Exodus-Thanatos/LUMINARA/DesignProject/documentation/diagrams/Functional_Block_Diagram.png

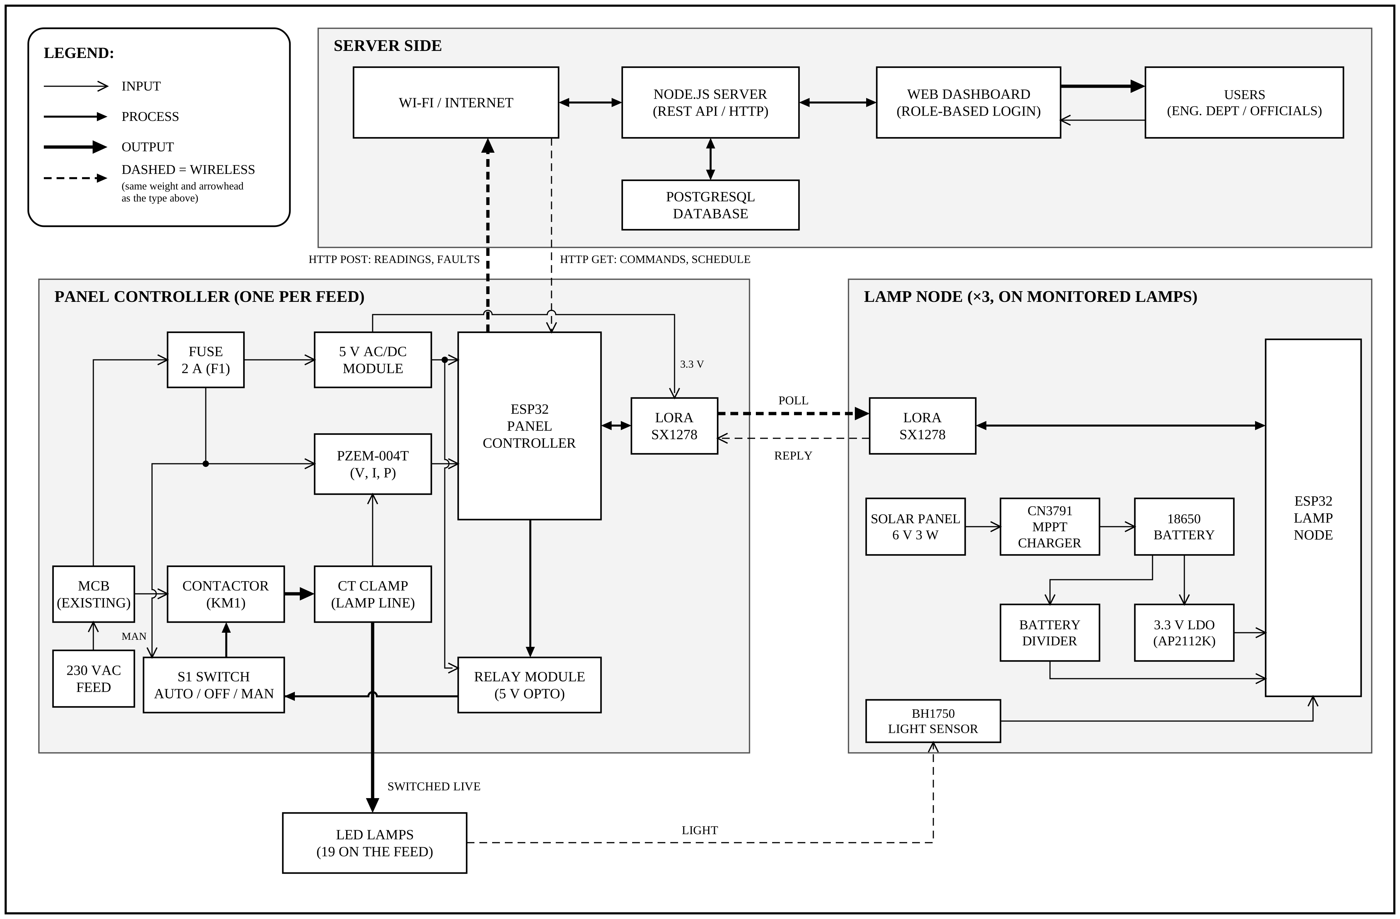
DesignProject/documentation/diagrams/Functional_Block_Diagram.png
