Exodus-Thanatos/LUMINARA/DesignProject/documentation/diagrams/General_Process_Flow_Diagram.png

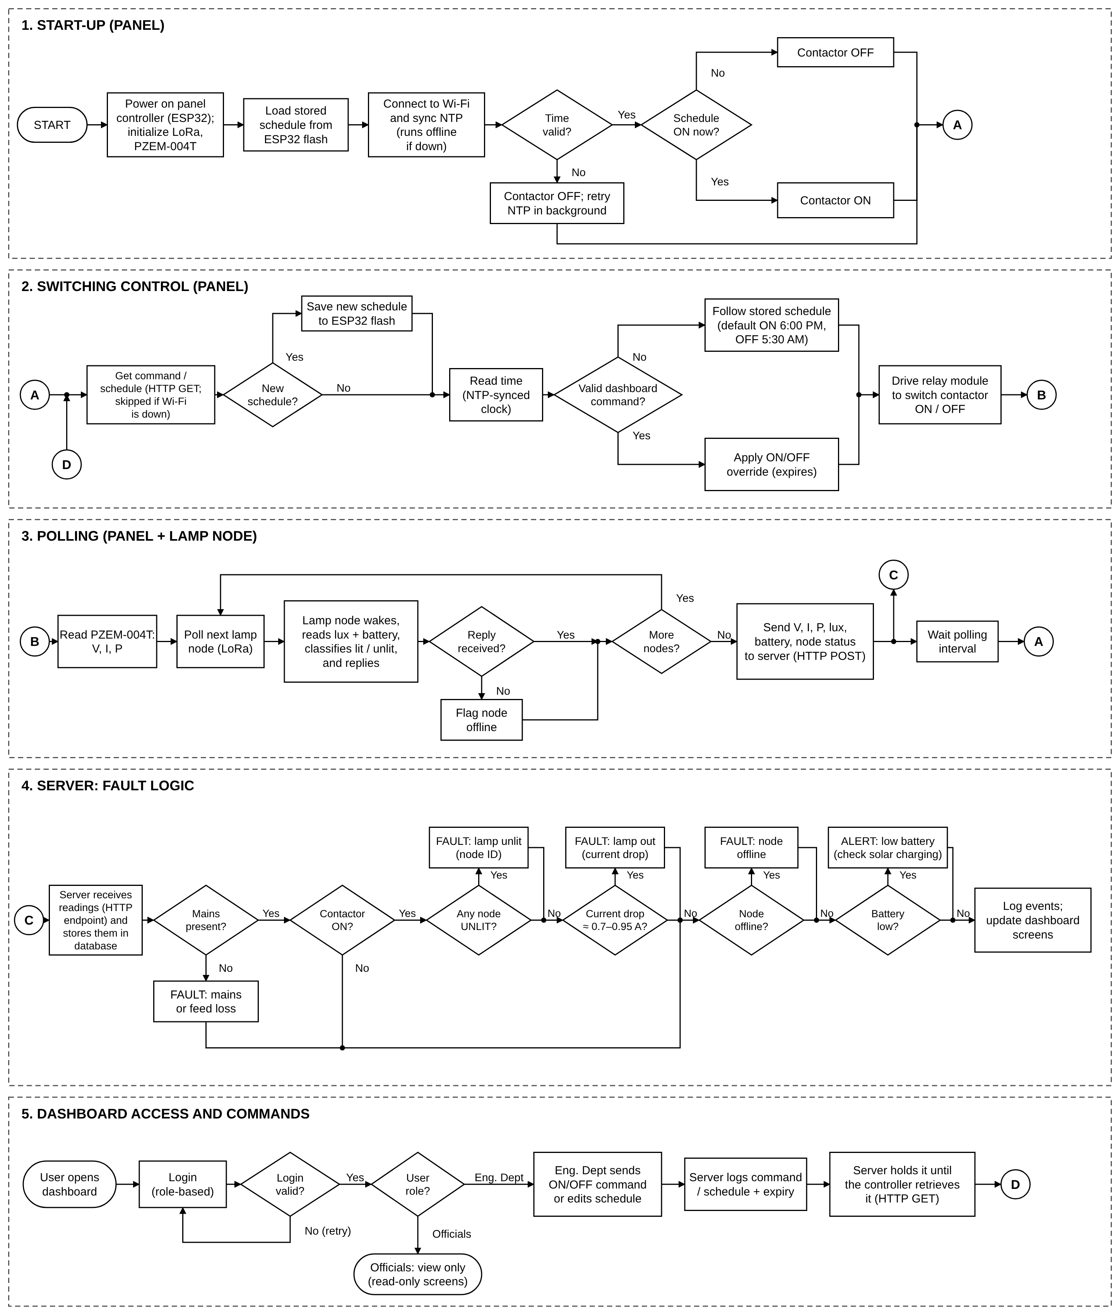
DesignProject/documentation/diagrams/General_Process_Flow_Diagram.png
