Exodus-Thanatos/LUMINARA/DesignProject/documentation/diagrams/General_Schematic_Diagram.png

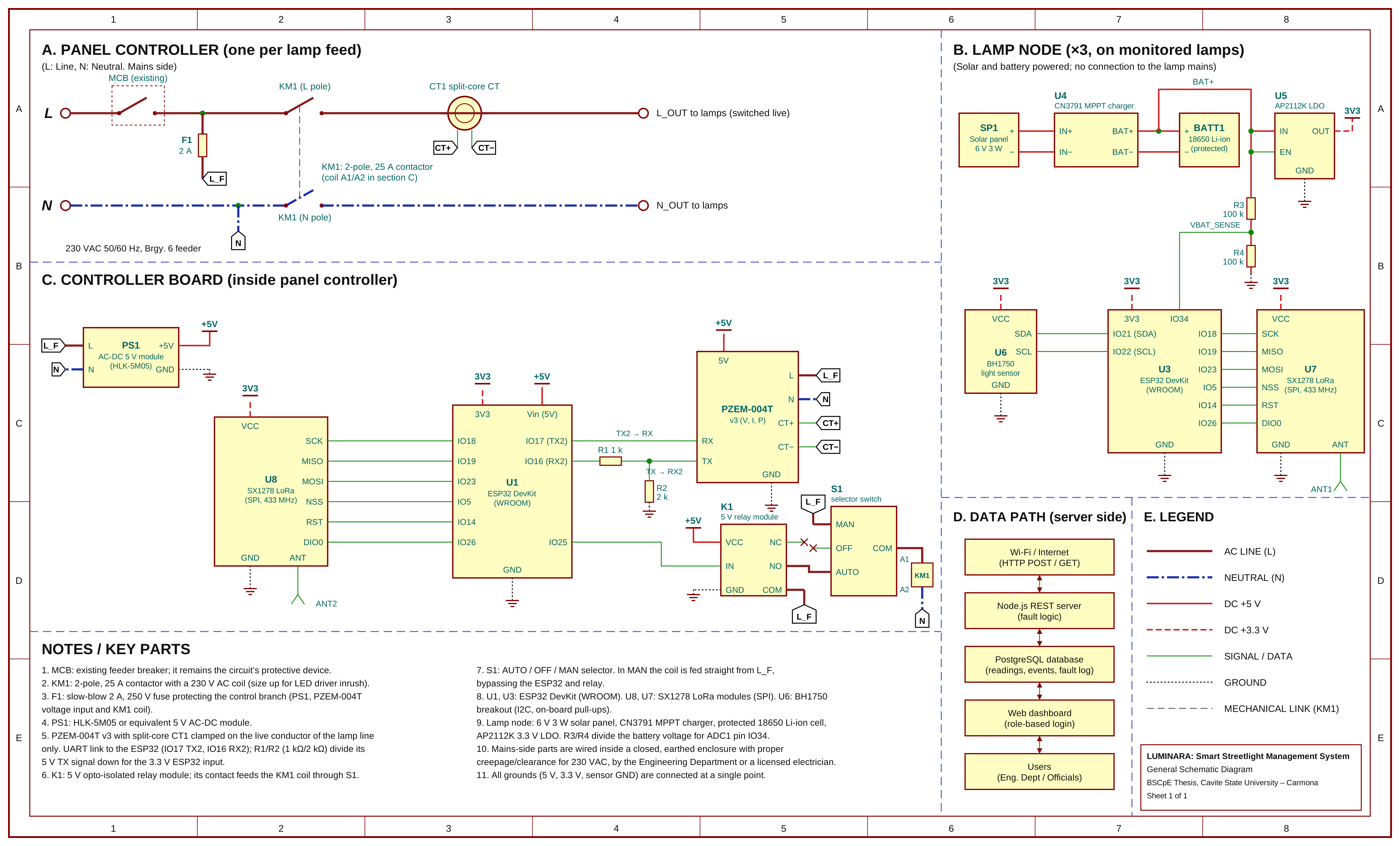
DesignProject/documentation/diagrams/General_Schematic_Diagram.png
