Exodus-Thanatos/LUMINARA/(commit log)

2026-10-21 ESP32 Test Codes
    For Range Testing and Light Sensor Testing
2026-10-21 Updated main ReadMe
    Based on thesis' current progress
2026-10-24 Added CSV Export Button
    For mass exporting lamplight locations
2026-10-29 Code for Relay (Aggregate Control)
